OWON-LILLIPUT/scopefun-hardware/README.md

**ScopeFun hardware**

This repository contains Scopefun hardware schematics and pcb layout files.

Licensed under CERN OHL v.1.2

You will need [Kicad](http://kicad-pcb.org/) to open hardware design files
