OWON-LILLIPUT/scopefun-hardware/KiCadSource/file584BA872.sch

## KiCad design KiCadSource/file584BA872.sch (2019-11-21)

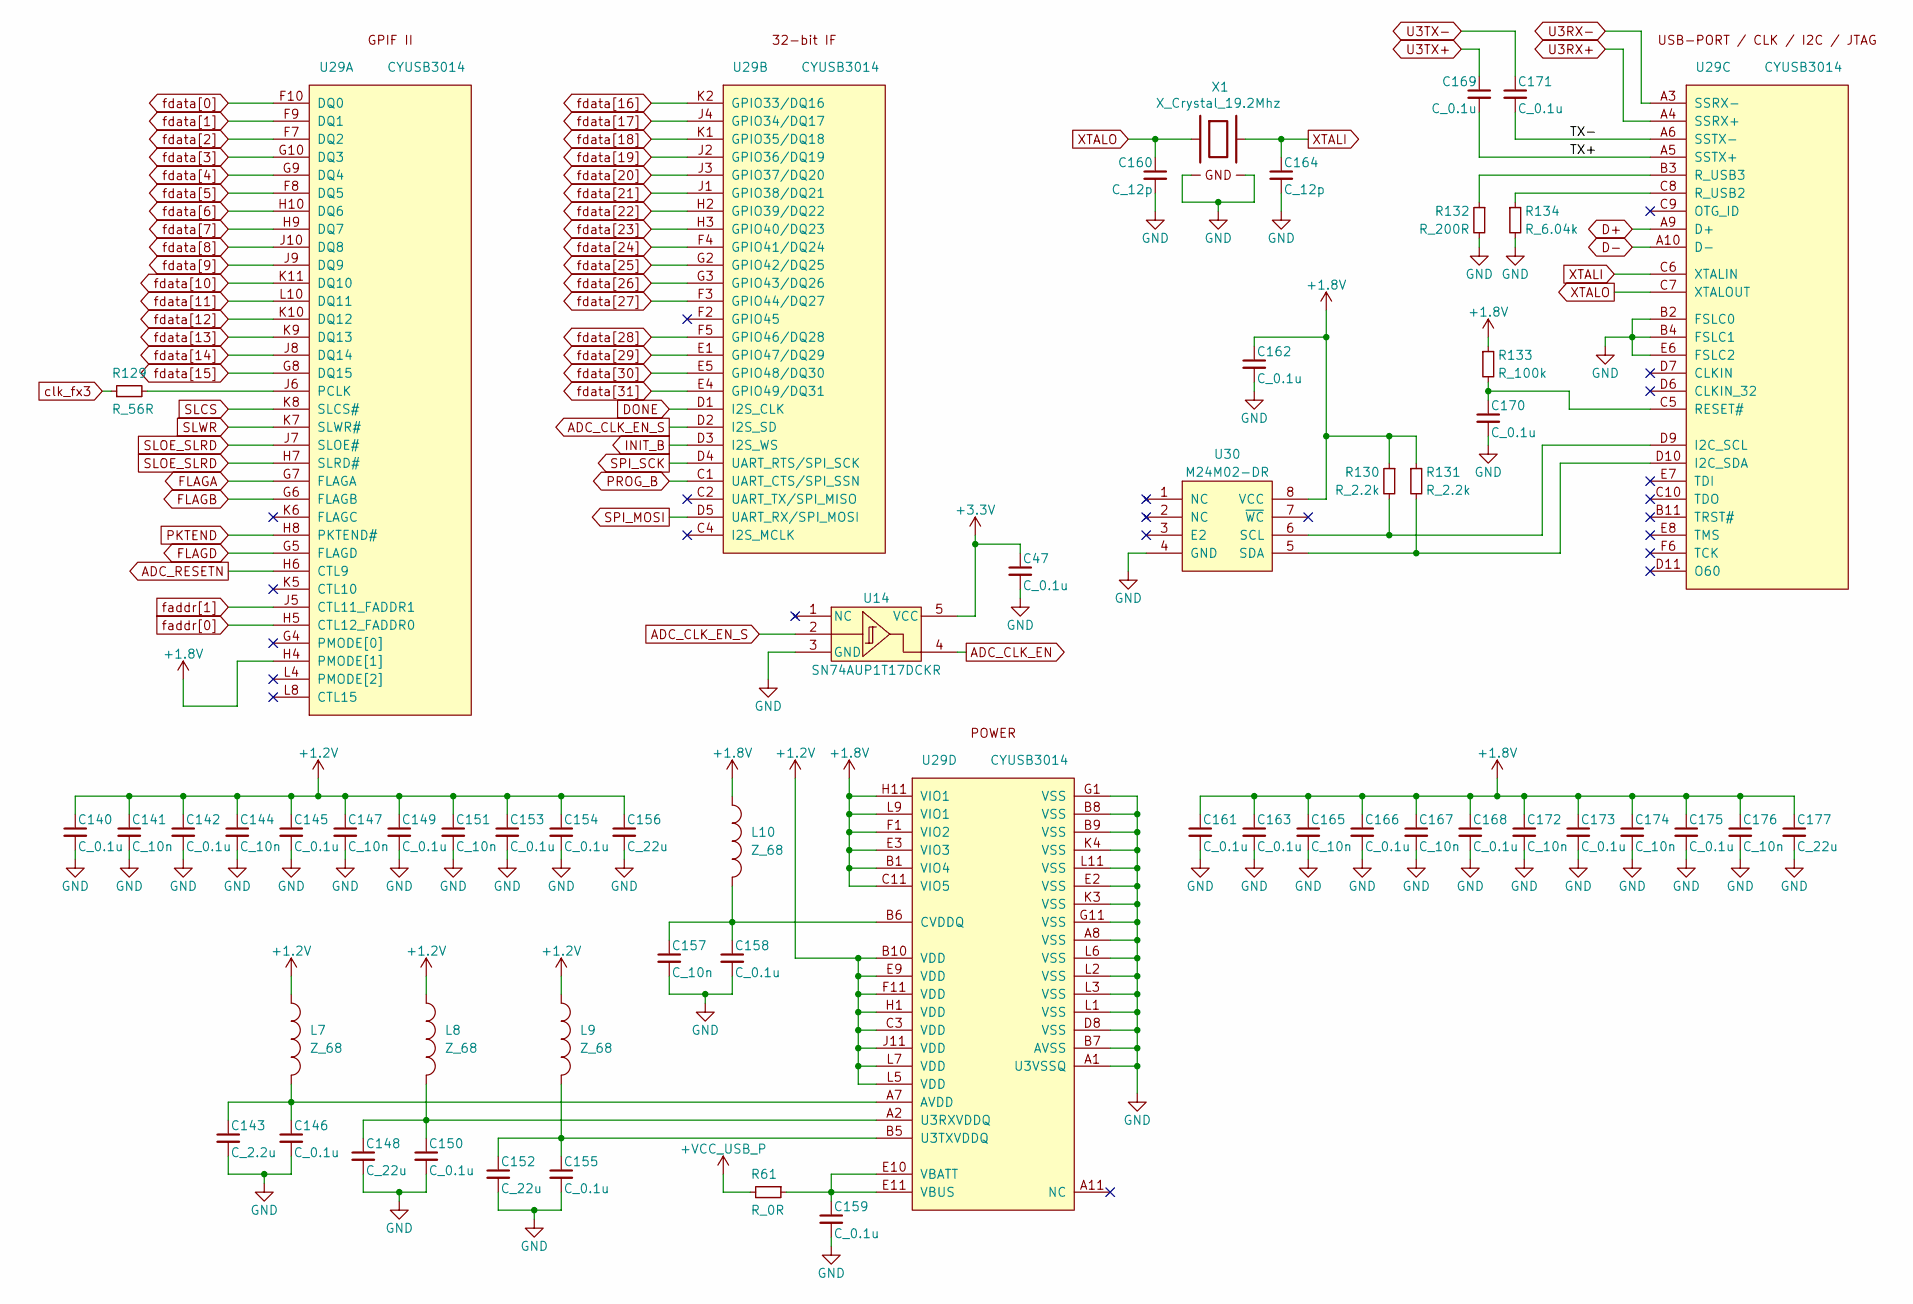
[picture p18: schematic file584BA872.sch]

Parts:
C47, C140, C142, C145, C146, C149, C150, C153, C154, C155, C158, C159, C161, C162, C163, C166, C168, C170, C173, C175: C_0.1u; C_0603; MFG Part# C0603C104K4RACTU
C141, C144, C147, C151, C157, C165, C167, C172, C174, C176: C_10n; C_0603; MFG Part# GRM1885C1H103JA01D
C143: C_2.2u; C_0603; MFG Part# CC0603MRX5R5BB225
C148, C152, C156, C177: C_22u; C_0805; MFG Part# LMK212BBJ226MG-T
C160, C164: C_12p; C_0603; MFG Part# CGA3E2C0G1H120J080AA
C169, C171: C_0.1u; C_0402; MFG Part# 885012205018
L7, L8, L9, L10: Z_68; L_0805; MFG Part# 782853680
R61: R_0R; R_0805; MFG Part# ERJ-6GEY0R00V
R129: R_56R; R_0603; MFG Part# ERJ-3EKF56R0V
R130, R131: R_2.2k; R_0603; MFG Part# ERJ-3EKF2201V
R132: R_200R; R_0603; MFG Part# ERJ-3EKF2000V
R133: R_100k; R_0603; MFG Part# ERJ-3EKF1003V
R134: R_6.04k; R_0603; MFG Part# ERJ-3EKF6041V
U14: SN74AUP1T17DCKR; SC70-5; MFG Part# SN74AUP1T17DCKR
U29: CYUSB3014; BGA121_0.8mm; MFG Part# CYUSB3014-BZXC
U30: M24M02-DR; SOIC8; MFG Part# M24M02-DRMN6TP
X1: X_Crystal_19.2Mhz; XTAL-4; MFG Part# FL1920031

Connections:
+1.2V: C140.1, C141.1, C142.1, C144.1, C145.1, C147.1, C149.1, C151.1, C153.1, C154.1, C156.1, L7.1, L8.1, L9.1, U29.B10 (VDD), U29.C3 (VDD), U29.E9 (VDD), U29.F11 (VDD), U29.H1 (VDD), U29.J11 (VDD), U29.L5 (VDD), U29.L7 (VDD)
+1.8V: C161.1, C162.1, C163.1, C165.1, C166.1, C167.1, C168.1, C172.1, C173.1, C174.1, C175.1, C176.1, C177.1, L10.1, R130.1, R131.1, R133.1, U29.B1 (VIO4), U29.C11 (VIO5), U29.E3 (VIO3), U29.F1 (VIO2), U29.H4 (PMODE[1]), U29.H11 (VIO1), U29.L9 (VIO1), U30.8 (VCC)
+3.3V: C47.1, U14.5 (VCC)
+VCC_USB_P: R61.2
ADC_CLK_EN: U14.4
ADC_CLK_EN_S: U14.2, U29.D2 (I2S_SD)
ADC_RESETN: U29.H6 (CTL9)
D+: U29.A9 (D+)
D-: U29.A10 (D-)
DONE: U29.D1 (I2S_CLK)
FLAGA: U29.G7 (FLAGA)
FLAGB: U29.G6 (FLAGB)
FLAGD: U29.G5 (FLAGD)
GND: C47.2, C140.2, C141.2, C142.2, C143.2, C144.2, C145.2, C146.2, C147.2, C148.2, C149.2, C150.2, C151.2, C152.2, C153.2, C154.2, C155.2, C156.2, C157.2, C158.2, C159.2, C160.2, C161.2, C162.2, C163.2, C164.2, C165.2, C166.2, C167.2, C168.2, C170.2, C172.2, C173.2, C174.2, C175.2, C176.2, C177.2, R132.2, R134.2, U14.3 (GND), U29.A1 (U3VSSQ), U29.A8 (VSS), U29.B2 (FSLC0), U29.B4 (FSLC1), U29.B7 (AVSS), U29.B8 (VSS), U29.B9 (VSS), U29.D8 (VSS), U29.E2 (VSS), U29.E6 (FSLC2), U29.G1 (VSS), U29.G11 (VSS), U29.K3 (VSS), U29.K4 (VSS), U29.L1 (VSS), U29.L2 (VSS), U29.L3 (VSS), U29.L6 (VSS), U29.L11 (VSS), U30.4 (GND), X1.2 (GND), X1.4 (GND)
INIT_B: U29.D3 (I2S_WS)
unnamed: C143.1, C146.1, L7.2, U29.A7 (AVDD)
unnamed: C148.1, C150.1, L8.2, U29.A2 (U3RXVDDQ)
unnamed: C152.1, C155.1, L9.2, U29.B5 (U3TXVDDQ)
unnamed: C157.1, C158.1, L10.2, U29.B6 (CVDDQ)
unnamed: C159.1, R61.1, U29.E10 (VBATT), U29.E11 (VBUS)
unnamed: C170.1, R133.2, U29.C5 (RESET#)
unnamed: R129.2, U29.J6 (PCLK)
unnamed: R130.2, U29.D9 (I2C_SCL), U30.6 (SCL)
unnamed: R131.2, U29.D10 (I2C_SDA), U30.5 (SDA)
unnamed: R132.1, U29.B3 (R_USB3)
unnamed: R134.1, U29.C8 (R_USB2)
PKTEND: U29.H8 (PKTEND#)
PROG_B: U29.C1 (UART_CTS/SPI_SSN)
SLCS: U29.K8 (SLCS#)
SLOE_SLRD: U29.H7 (SLRD#), U29.J7 (SLOE#)
SLWR: U29.K7 (SLWR#)
SPI_MOSI: U29.D5 (UART_RX/SPI_MOSI)
SPI_SCK: U29.D4 (UART_RTS/SPI_SCK)
TX+: C169.2, U29.A5 (SSTX+)
TX-: C171.2, U29.A6 (SSTX-)
U3RX+: U29.A4 (SSRX+)
U3RX-: U29.A3 (SSRX-)
U3TX+: C169.1
U3TX-: C171.1
XTALI: C164.1, U29.C6 (XTALIN), X1.3
XTALO: C160.1, U29.C7 (XTALOUT), X1.1
clk_fx3: R129.1
faddr[0]: U29.H5 (CTL12_FADDR0)
faddr[1]: U29.J5 (CTL11_FADDR1)
fdata[0]: U29.F10 (DQ0)
fdata[1]: U29.F9 (DQ1)
fdata[2]: U29.F7 (DQ2)
fdata[3]: U29.G10 (DQ3)
fdata[4]: U29.G9 (DQ4)
fdata[5]: U29.F8 (DQ5)
fdata[6]: U29.H10 (DQ6)
fdata[7]: U29.H9 (DQ7)
fdata[8]: U29.J10 (DQ8)
fdata[9]: U29.J9 (DQ9)
fdata[10]: U29.K11 (DQ10)
fdata[11]: U29.L10 (DQ11)
fdata[12]: U29.K10 (DQ12)
fdata[13]: U29.K9 (DQ13)
fdata[14]: U29.J8 (DQ14)
fdata[15]: U29.G8 (DQ15)
fdata[16]: U29.K2 (GPIO33/DQ16)
fdata[17]: U29.J4 (GPIO34/DQ17)
fdata[18]: U29.K1 (GPIO35/DQ18)
fdata[19]: U29.J2 (GPIO36/DQ19)
fdata[20]: U29.J3 (GPIO37/DQ20)
fdata[21]: U29.J1 (GPIO38/DQ21)
fdata[22]: U29.H2 (GPIO39/DQ22)
fdata[23]: U29.H3 (GPIO40/DQ23)
fdata[24]: U29.F4 (GPIO41/DQ24)
fdata[25]: U29.G2 (GPIO42/DQ25)
fdata[26]: U29.G3 (GPIO43/DQ26)
fdata[27]: U29.F3 (GPIO44/DQ27)
fdata[28]: U29.F5 (GPIO46/DQ28)
fdata[29]: U29.E1 (GPIO47/DQ29)
fdata[30]: U29.E5 (GPIO48/DQ30)
fdata[31]: U29.E4 (GPIO49/DQ31)
