OWON-LILLIPUT/scopefun-hardware/KiCadSource/file56954A3C.sch

## KiCad design KiCadSource/file56954A3C.sch (2019-11-21)

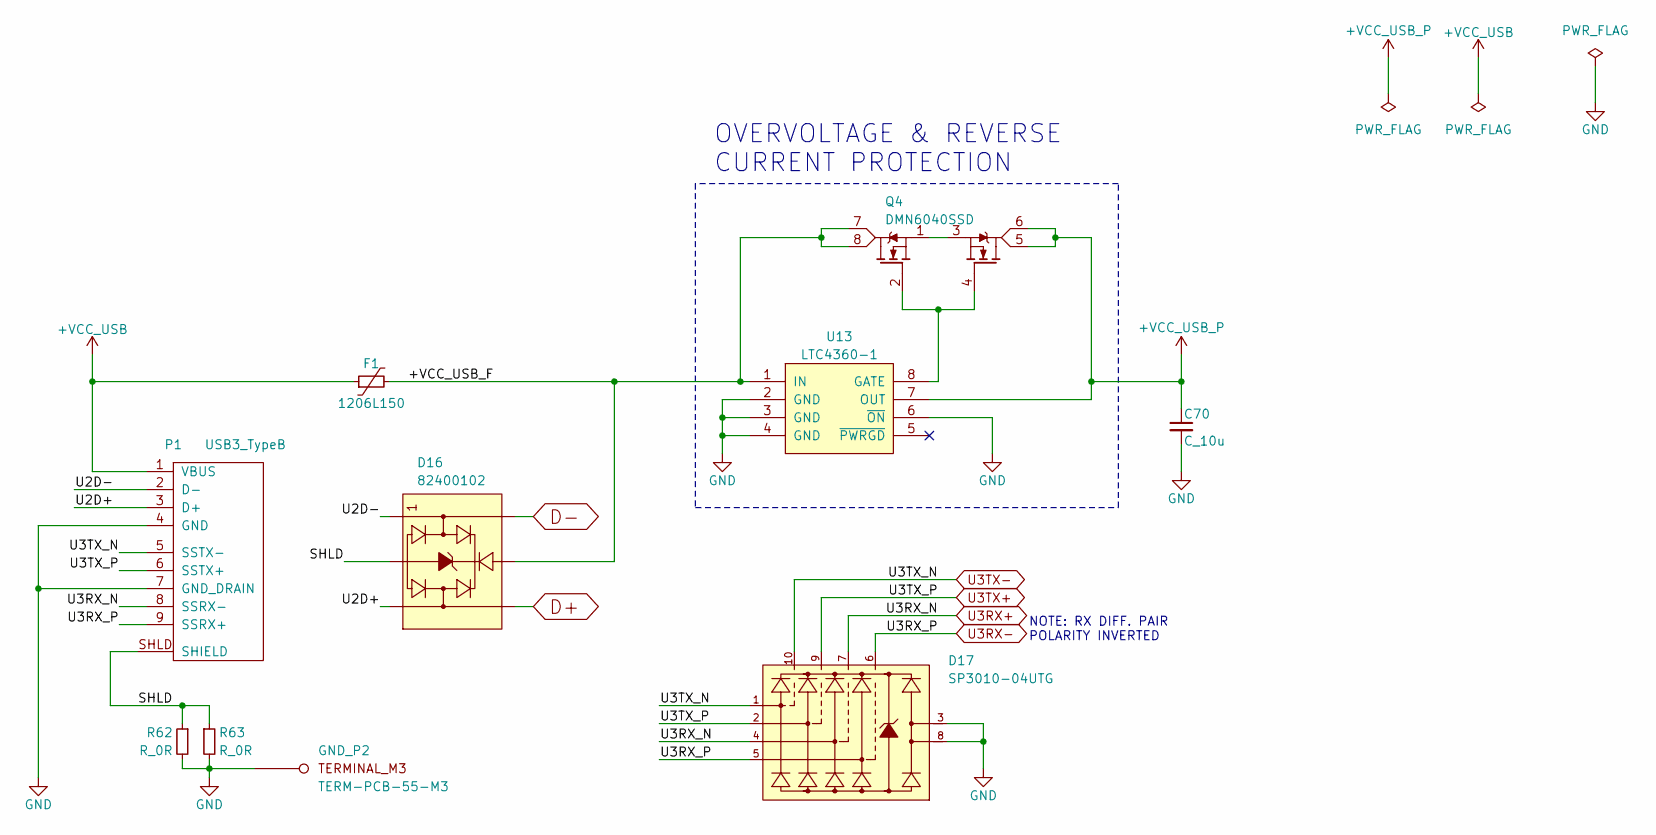
[picture p24: schematic file56954A3C.sch]

Parts:
C70: C_10u; C_0603; MFG Part# GRM188R60J106KE47D
D16: 82400102; SOT23-6; MFG Part# 82400102
D17: SP3010-04UTG; uDFN-10; MFG Part# SP3010-04UTG
F1: 1206L150; R_1206; MFG Part# 1206L150THWR
GND_P2: TERM-PCB-55-M3; MFG Part# PCB-55(M3)
P1: USB3_TypeB; MFG Part# 692221030100
Q4: DMN6040SSD; SOIC8; MFG Part# DMN6040SSD-13
R62, R63: R_0R; R_0805; MFG Part# ERJ-6GEY0R00V
U13: LTC4360-1; SC70; MFG Part# LTC4360CSC8-1

Connections:
+VCC_USB: F1.1, P1.1 (VBUS)
+VCC_USB_F: D16.5 (VDD), F1.2, Q4.7 (D1), Q4.8 (D1), U13.1 (IN)
+VCC_USB_P: C70.1, Q4.5 (D2), Q4.6 (D2), U13.7 (OUT)
D+: D16.4 (IO2)
D-: D16.6 (IO1)
GND: C70.2, D17.3 (IO2), D17.8 (IO1), GND_P2.1, P1.4 (GND), P1.7 (GND_DRAIN), R62.2, R63.2, U13.2 (GND), U13.3 (GND), U13.4 (GND), U13.6 (~ON)
unnamed: Q4.1 (S1), Q4.3 (S2)
unnamed: Q4.2 (G1), Q4.4 (G2), U13.8 (GATE)
SHLD: D16.2 (GND), P1.SHLD (SHIELD), R62.1, R63.1
U2D+: D16.3 (IO2), P1.3 (D+)
U2D-: D16.1 (IO1), P1.2 (D-)
U3RX+: D17.4 (IO2), D17.7 (IO1), P1.8 (SSRX-)
U3RX-: D17.5 (VDD), D17.6 (IO1), P1.9 (SSRX+)
U3TX+: D17.2 (GND), D17.9 (IO1), P1.6 (SSTX+)
U3TX-: D17.1 (IO1), D17.10 (IO1), P1.5 (SSTX-)

Notes on the sheet:
OVERVOLTAGE & REVERSE CURRENT PROTECTION
NOTE: RX DIFF. PAIR POLARITY INVERTED
