OWON-LILLIPUT/scopefun-hardware/KiCadSource/file58568C5C.sch

## KiCad design KiCadSource/file58568C5C.sch (2019-11-21)

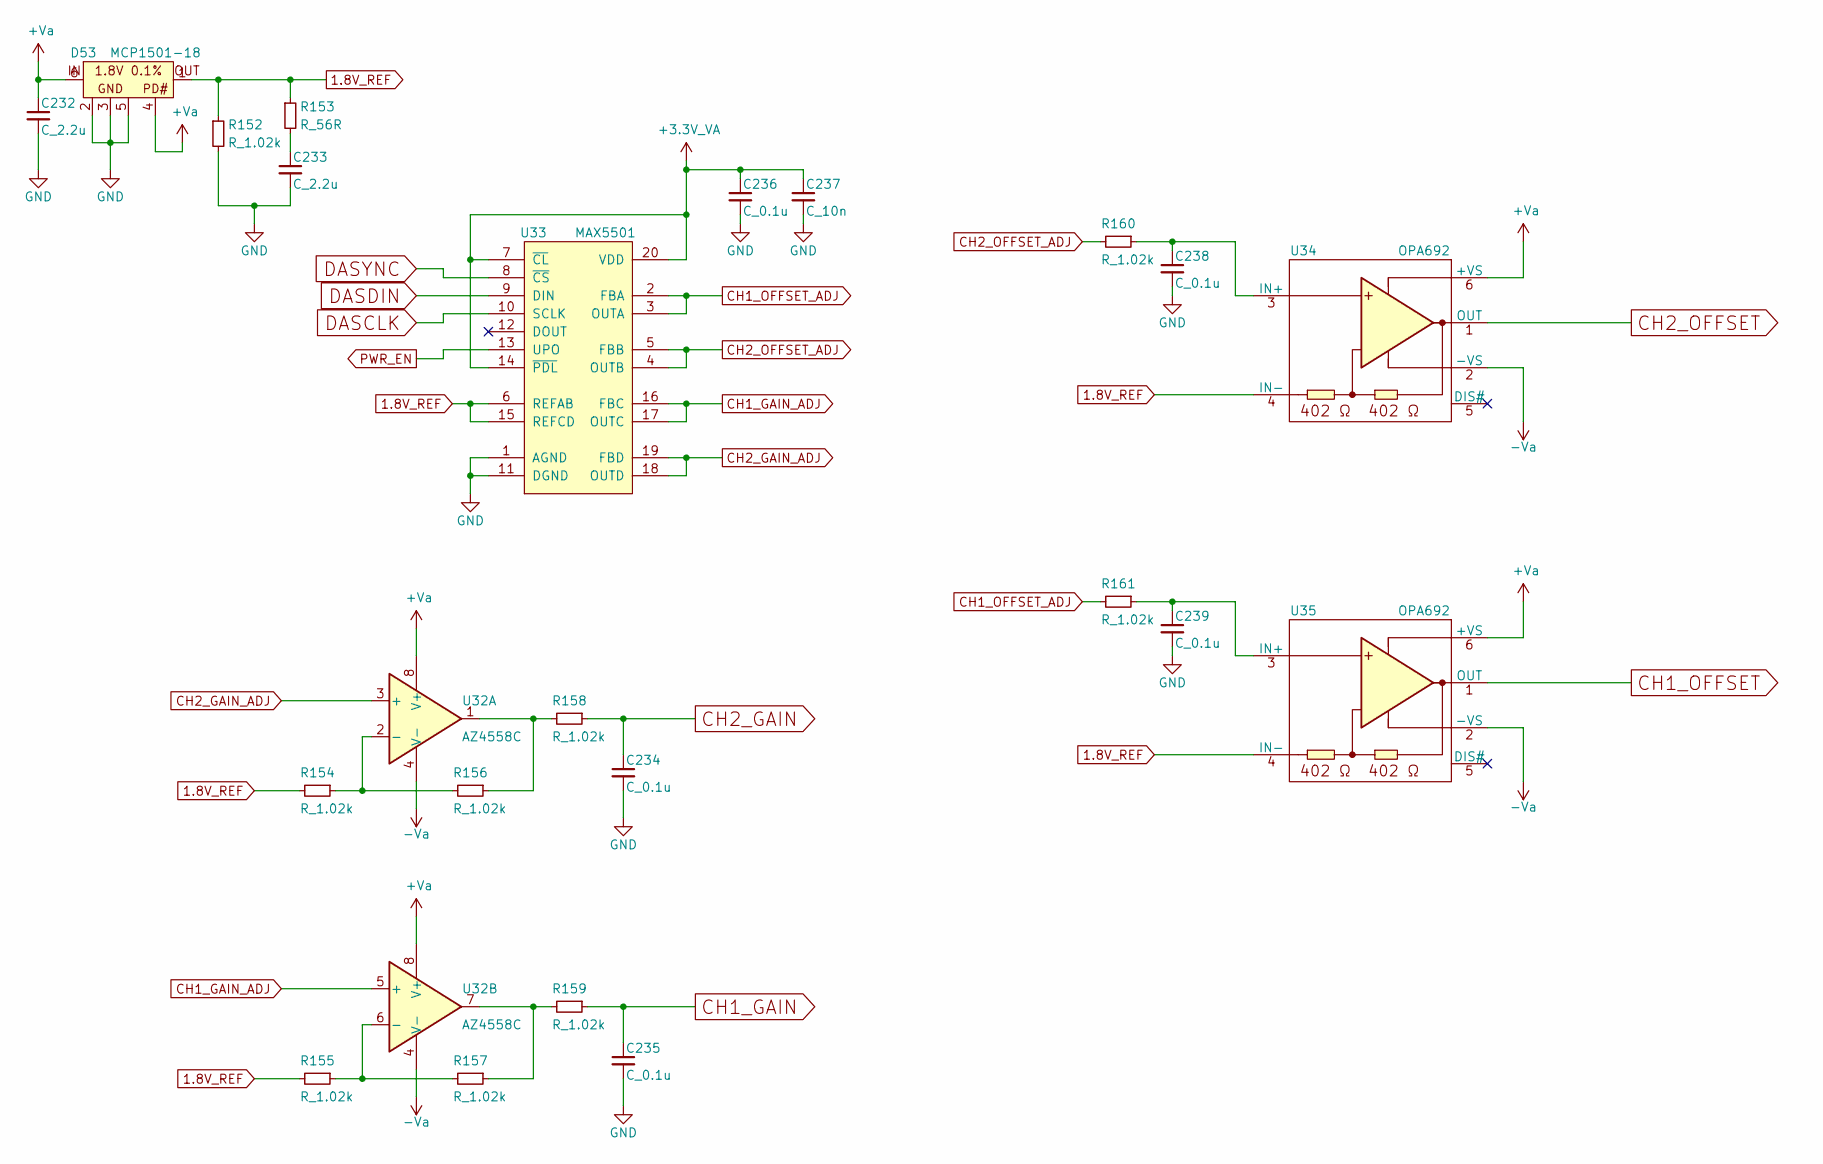
[picture p25: schematic file58568C5C.sch]

Parts:
C232, C233: C_2.2u; C_0603; MFG Part# CC0603MRX5R5BB225
C234, C235, C236, C238, C239: C_0.1u; C_0603; MFG Part# C0603C104K4RACTU
C237: C_10n; C_0402; MFG Part# 885012205012
D53: MCP1501-18; SOT23-6; MFG Part# MCP1501T-18E/CHY
R152, R154, R155, R156, R157, R158, R159, R160, R161: R_1.02k; R_0603; MFG Part# ERJ-3EKF1021V
R153: R_56R; R_0603; MFG Part# ERJ-3EKF56R0V
U32: AZ4558C; SOIC8; MFG Part# AZ4558CMTR-E1
U33: MAX5501; SSOP20; MFG Part# MAX5501BGAP+
U34, U35: OPA692; SOT23-6; MFG Part# OPA692IDBVT

Connections:
1.8V_REF: D53.1 (OUT), R152.1, R153.1, R154.2, R155.2, U33.6 (REFAB), U33.15 (REFCD), U34.4 (IN-), U35.4 (IN-)
+3.3V_VA: C236.1, C237.1, U33.7 (~CL), U33.14 (~PDL), U33.20 (VDD)
+Va: C232.1, D53.4 (SHDN#), D53.6 (VDD), U32.8 (V+), U34.6 (+VS), U35.6 (+VS)
-Va: U32.4 (V-), U34.2 (-VS), U35.2 (-VS)
CH1_GAIN: C235.1, R159.1
CH1_GAIN_ADJ: U32.5 (+), U33.16 (FBC), U33.17 (OUTC)
CH1_OFFSET: U35.1 (OUT)
CH1_OFFSET_ADJ: R161.2, U33.2 (FBA), U33.3 (OUTA)
CH2_GAIN: C234.1, R158.1
CH2_GAIN_ADJ: U32.3 (+), U33.18 (OUTD), U33.19 (FBD)
CH2_OFFSET: U34.1 (OUT)
CH2_OFFSET_ADJ: R160.2, U33.4 (OUTB), U33.5 (FBB)
DASCLK: U33.10 (SCLK)
DASDIN: U33.9 (DIN)
DASYNC: U33.8 (~CS)
GND: C232.2, C233.2, C234.2, C235.2, C236.2, C237.2, C238.2, C239.2, D53.2 (GND), D53.3 (GND), D53.5 (GND), R152.2, U33.1 (AGND), U33.11 (DGND)
unnamed: C233.1, R153.2
unnamed: C238.1, R160.1, U34.3 (IN+)
unnamed: C239.1, R161.1, U35.3 (IN+)
unnamed: R154.1, R156.2, U32.2 (-)
unnamed: R155.1, R157.2, U32.6 (-)
unnamed: R156.1, R158.2, U32.1
unnamed: R157.1, R159.2, U32.7
PWR_EN: U33.13 (UPO)
