OWON-LILLIPUT/scopefun-hardware/KiCadSource/file58589F31.sch

## KiCad design KiCadSource/file58589F31.sch (2019-11-21)

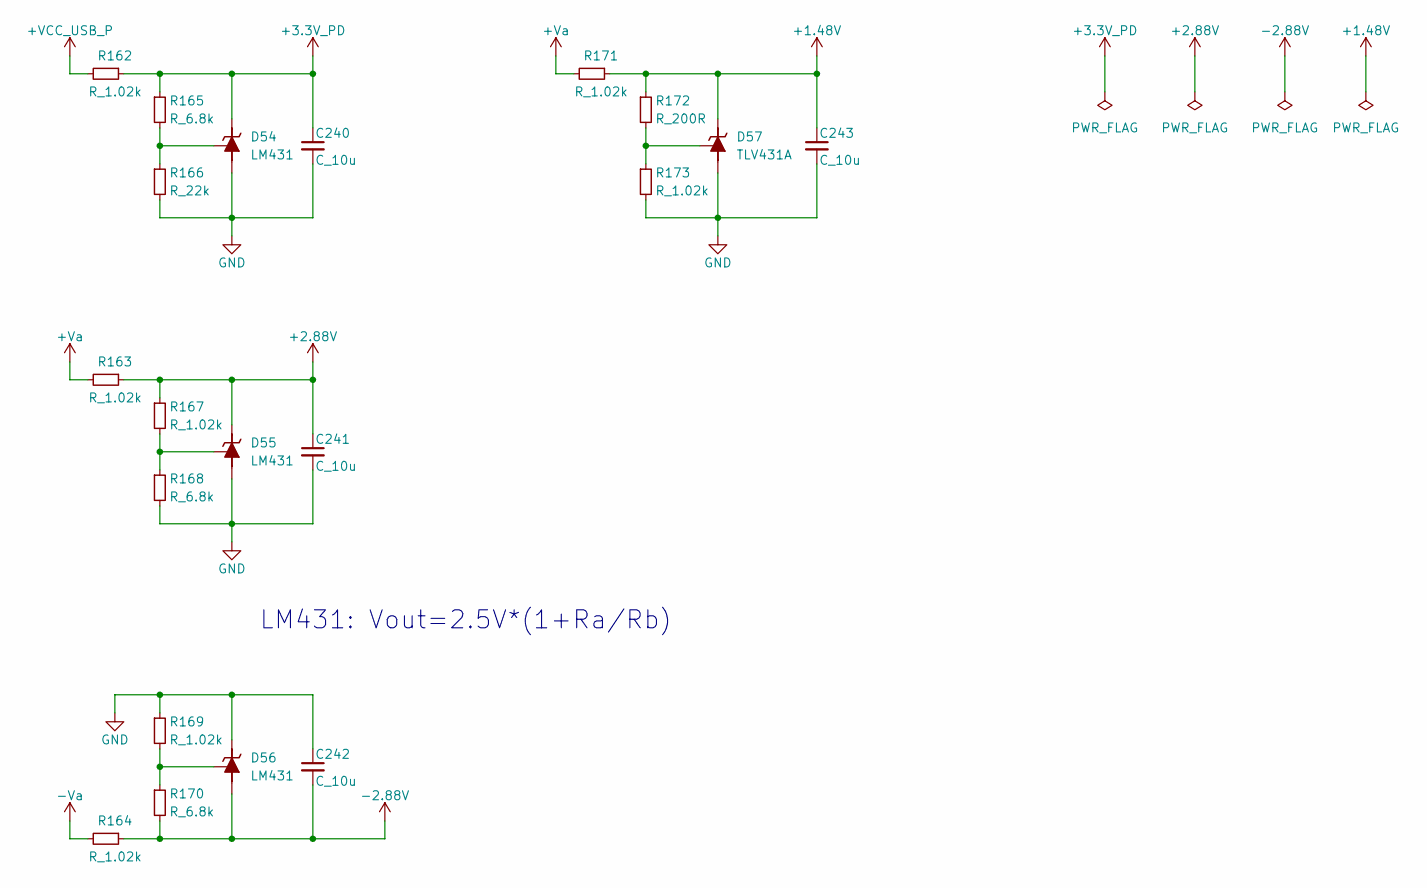
[picture p26: schematic file58589F31.sch]

Parts:
C240, C241, C242, C243: C_10u; C_0603; MFG Part# GRM188R60J106KE47D
D54, D55, D56: LM431; SOT23; MFG Part# LM431SBCM32X
D57: TLV431A; SOT23; MFG Part# TLV431ASN1T1G
R162, R163, R164, R167, R169, R171, R173: R_1.02k; R_0603; MFG Part# ERJ-3EKF1021V
R165, R168, R170: R_6.8k; R_0603; MFG Part# ERJ-3EKF6801V
R166: R_22k; R_0603; MFG Part# ERJ-3EKF2202V
R172: R_200R; R_0603; MFG Part# ERJ-3EKF2000V

Connections:
+1.48V: C243.1, D57.2 (C), R171.1, R172.1
+2.88V: C241.1, D55.1 (C), R163.1, R167.1
+3.3V_PD: C240.1, D54.1 (C), R162.1, R165.1
+VCC_USB_P: R162.2
+Va: R163.2, R171.2
-2.88V: C242.2, D56.3 (A), R164.1, R170.2
-Va: R164.2
GND: C240.2, C241.2, C242.1, C243.2, D54.3 (A), D55.3 (A), D56.1 (C), D57.3 (A), R166.2, R168.2, R169.1, R173.2
unnamed: D54.2 (REF), R165.2, R166.1
unnamed: D55.2 (REF), R167.2, R168.1
unnamed: D56.2 (REF), R169.2, R170.1
unnamed: D57.1 (REF), R172.2, R173.1

Notes on the sheet:
LM431: Vout=2.5V*(1+Ra/Rb)
