OWON-LILLIPUT/scopefun-hardware/KiCadSource/file58597EF4.sch

## KiCad design KiCadSource/file58597EF4.sch (2019-11-21)

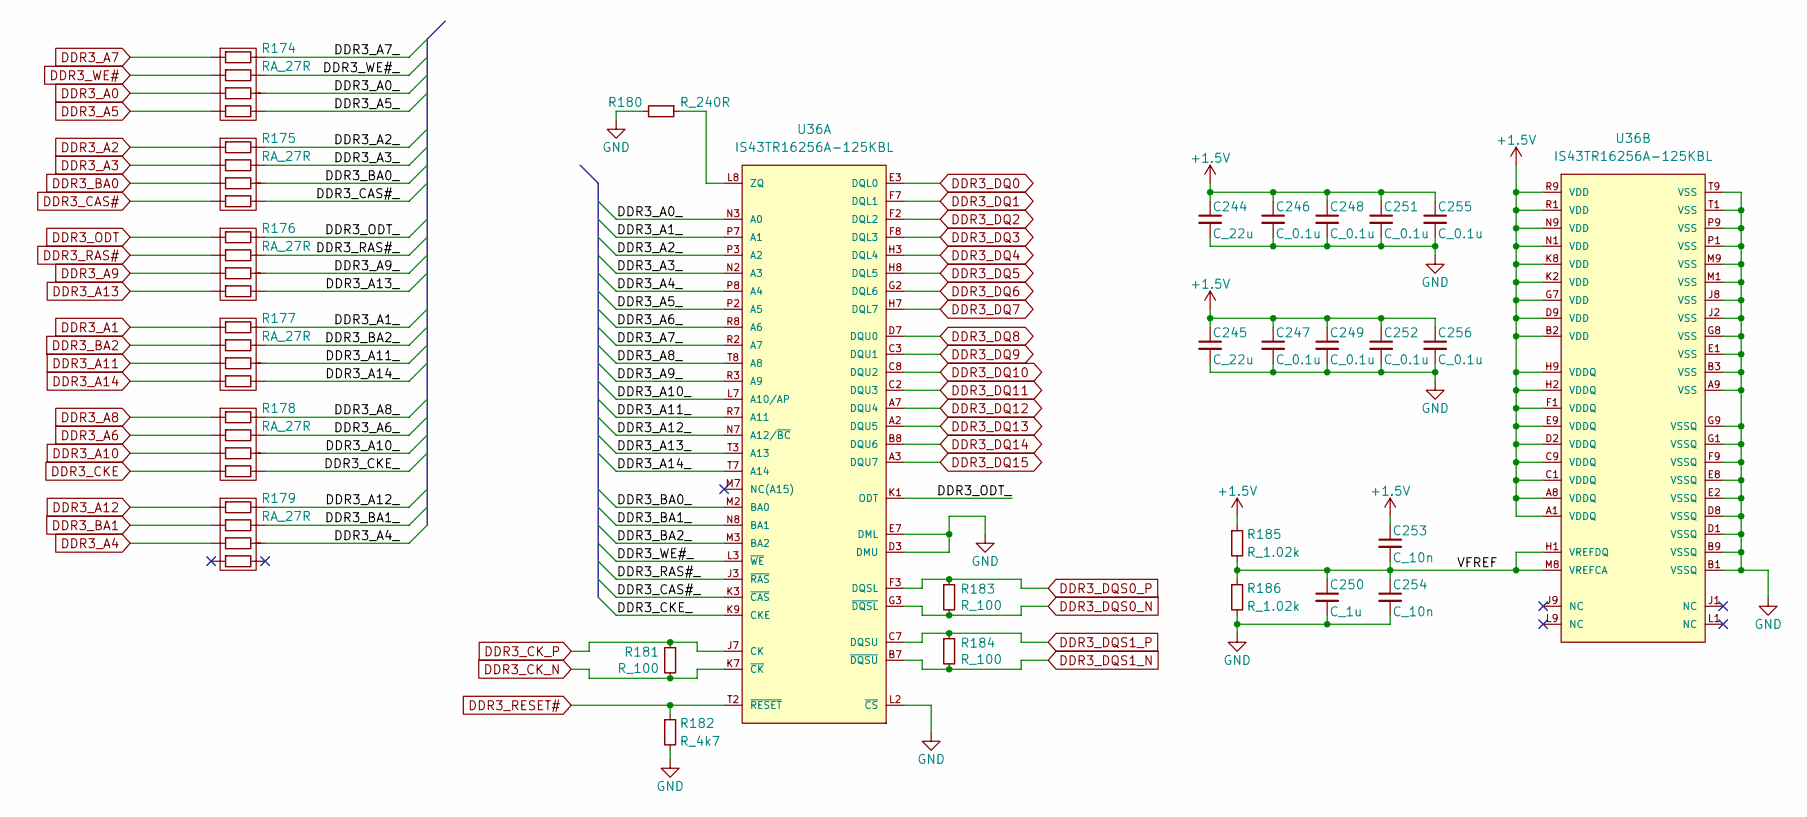
[picture p27: schematic file58597EF4.sch]

Parts:
C244, C245: C_22u; C_0805; MFG Part# LMK212BBJ226MG-T
C246, C247, C248, C249, C251, C252, C255, C256: C_0.1u; C_0603; MFG Part# C0603C104K4RACTU
C250: C_1u; C_0603; MFG Part# C0603C105K9PACTU
C253, C254: C_10n; C_0603; MFG Part# GRM1885C1H103JA01D
R174, R175, R176, R177, R178, R179: RA_27R; R_CRA06E; MFG Part# YC164-JR-0727RL
R180: R_240R; R_0603; MFG Part# ERJ-3EKF2400V
R181, R183, R184: R_100; R_0402; MFG Part# ERJ-2RKF1000X
R182: R_4k7; R_0603; MFG Part# ERJ-3EKF4701V
R185, R186: R_1.02k; R_0603; MFG Part# ERJ-3EKF1021V
U36: IS43TR16256A-125KBL; TW-BGA-96; MFG Part# IS43TR16256A-125KBL

Connections:
+1.5V: C244.1, C245.1, C246.1, C247.1, C248.1, C249.1, C251.1, C252.1, C253.1, C255.1, C256.1, R185.1, U36.A1 (VDDQ), U36.A8 (VDDQ), U36.B2 (VDD), U36.C1 (VDDQ), U36.C9 (VDDQ), U36.D2 (VDDQ), U36.D9 (VDD), U36.E9 (VDDQ), U36.F1 (VDDQ), U36.G7 (VDD), U36.H2 (VDDQ), U36.H9 (VDDQ), U36.K2 (VDD), U36.K8 (VDD), U36.N1 (VDD), U36.N9 (VDD), U36.R1 (VDD), U36.R9 (VDD)
DDR3_A0: R174.6
DDR3_A0_: R174.3, U36.N3 (A0)
DDR3_A1: R177.8
DDR3_A1_: R177.1, U36.P7 (A1)
DDR3_A2: R175.8
DDR3_A2_: R175.1, U36.P3 (A2)
DDR3_A3: R175.7
DDR3_A3_: R175.2, U36.N2 (A3)
DDR3_A4: R179.6
DDR3_A4_: R179.3, U36.P8 (A4)
DDR3_A5: R174.5
DDR3_A5_: R174.4, U36.P2 (A5)
DDR3_A6: R178.7
DDR3_A6_: R178.2, U36.R8 (A6)
DDR3_A7: R174.8
DDR3_A7_: R174.1, U36.R2 (A7)
DDR3_A8: R178.8
DDR3_A8_: R178.1, U36.T8 (A8)
DDR3_A9: R176.6
DDR3_A9_: R176.3, U36.R3 (A9)
DDR3_A10: R178.6
DDR3_A10_: R178.3, U36.L7 (A10/AP)
DDR3_A11: R177.6
DDR3_A11_: R177.3, U36.R7 (A11)
DDR3_A12: R179.8
DDR3_A12_: R179.1, U36.N7 (A12/~BC)
DDR3_A13: R176.5
DDR3_A13_: R176.4, U36.T3 (A13)
DDR3_A14: R177.5
DDR3_A14_: R177.4, U36.T7 (A14)
DDR3_BA0: R175.6
DDR3_BA0_: R175.3, U36.M2 (BA0)
DDR3_BA1: R179.7
DDR3_BA1_: R179.2, U36.N8 (BA1)
DDR3_BA2: R177.7
DDR3_BA2_: R177.2, U36.M3 (BA2)
DDR3_CAS#: R175.5
DDR3_CAS#_: R175.4, U36.K3 (~CAS)
DDR3_CKE: R178.5
DDR3_CKE_: R178.4, U36.K9 (CKE)
DDR3_CK_N: R181.2, U36.K7 (~CK)
DDR3_CK_P: R181.1, U36.J7 (CK)
DDR3_DQ0: U36.E3 (DQL0)
DDR3_DQ1: U36.F7 (DQL1)
DDR3_DQ2: U36.F2 (DQL2)
DDR3_DQ3: U36.F8 (DQL3)
DDR3_DQ4: U36.H3 (DQL4)
DDR3_DQ5: U36.H8 (DQL5)
DDR3_DQ6: U36.G2 (DQL6)
DDR3_DQ7: U36.H7 (DQL7)
DDR3_DQ8: U36.D7 (DQU0)
DDR3_DQ9: U36.C3 (DQU1)
DDR3_DQ10: U36.C8 (DQU2)
DDR3_DQ11: U36.C2 (DQU3)
DDR3_DQ12: U36.A7 (DQU4)
DDR3_DQ13: U36.A2 (DQU5)
DDR3_DQ14: U36.B8 (DQU6)
DDR3_DQ15: U36.A3 (DQU7)
DDR3_DQS0_N: R183.2, U36.G3 (~DQSL)
DDR3_DQS0_P: R183.1, U36.F3 (DQSL)
DDR3_DQS1_N: R184.2, U36.B7 (~DQSU)
DDR3_DQS1_P: R184.1, U36.C7 (DQSU)
DDR3_ODT: R176.8
DDR3_ODT_: R176.1, U36.K1 (ODT)
DDR3_RAS#: R176.7
DDR3_RAS#_: R176.2, U36.J3 (~RAS)
DDR3_RESET#: R182.1, U36.T2 (~RESET)
DDR3_WE#: R174.7
DDR3_WE#_: R174.2, U36.L3 (~WE)
GND: C244.2, C245.2, C246.2, C247.2, C248.2, C249.2, C250.2, C251.2, C252.2, C254.2, C255.2, C256.2, R180.2, R182.2, R186.2, U36.A9 (VSS), U36.B1 (VSSQ), U36.B3 (VSS), U36.B9 (VSSQ), U36.D1 (VSSQ), U36.D3 (DMU), U36.D8 (VSSQ), U36.E1 (VSS), U36.E2 (VSSQ), U36.E7 (DML), U36.E8 (VSSQ), U36.F9 (VSSQ), U36.G1 (VSSQ), U36.G8 (VSS), U36.G9 (VSSQ), U36.J2 (VSS), U36.J8 (VSS), U36.L2 (~CS), U36.M1 (VSS), U36.M9 (VSS), U36.P1 (VSS), U36.P9 (VSS), U36.T1 (VSS), U36.T9 (VSS)
unnamed: R180.1, U36.L8 (ZQ)
VFREF: C250.1, C253.2, C254.1, R185.2, R186.1, U36.H1 (VREFDQ), U36.M8 (VREFCA)
