OWON-LILLIPUT/scopefun-hardware/KiCadSource/file56921512.sch

## KiCad design KiCadSource/file56921512.sch (2019-11-21)

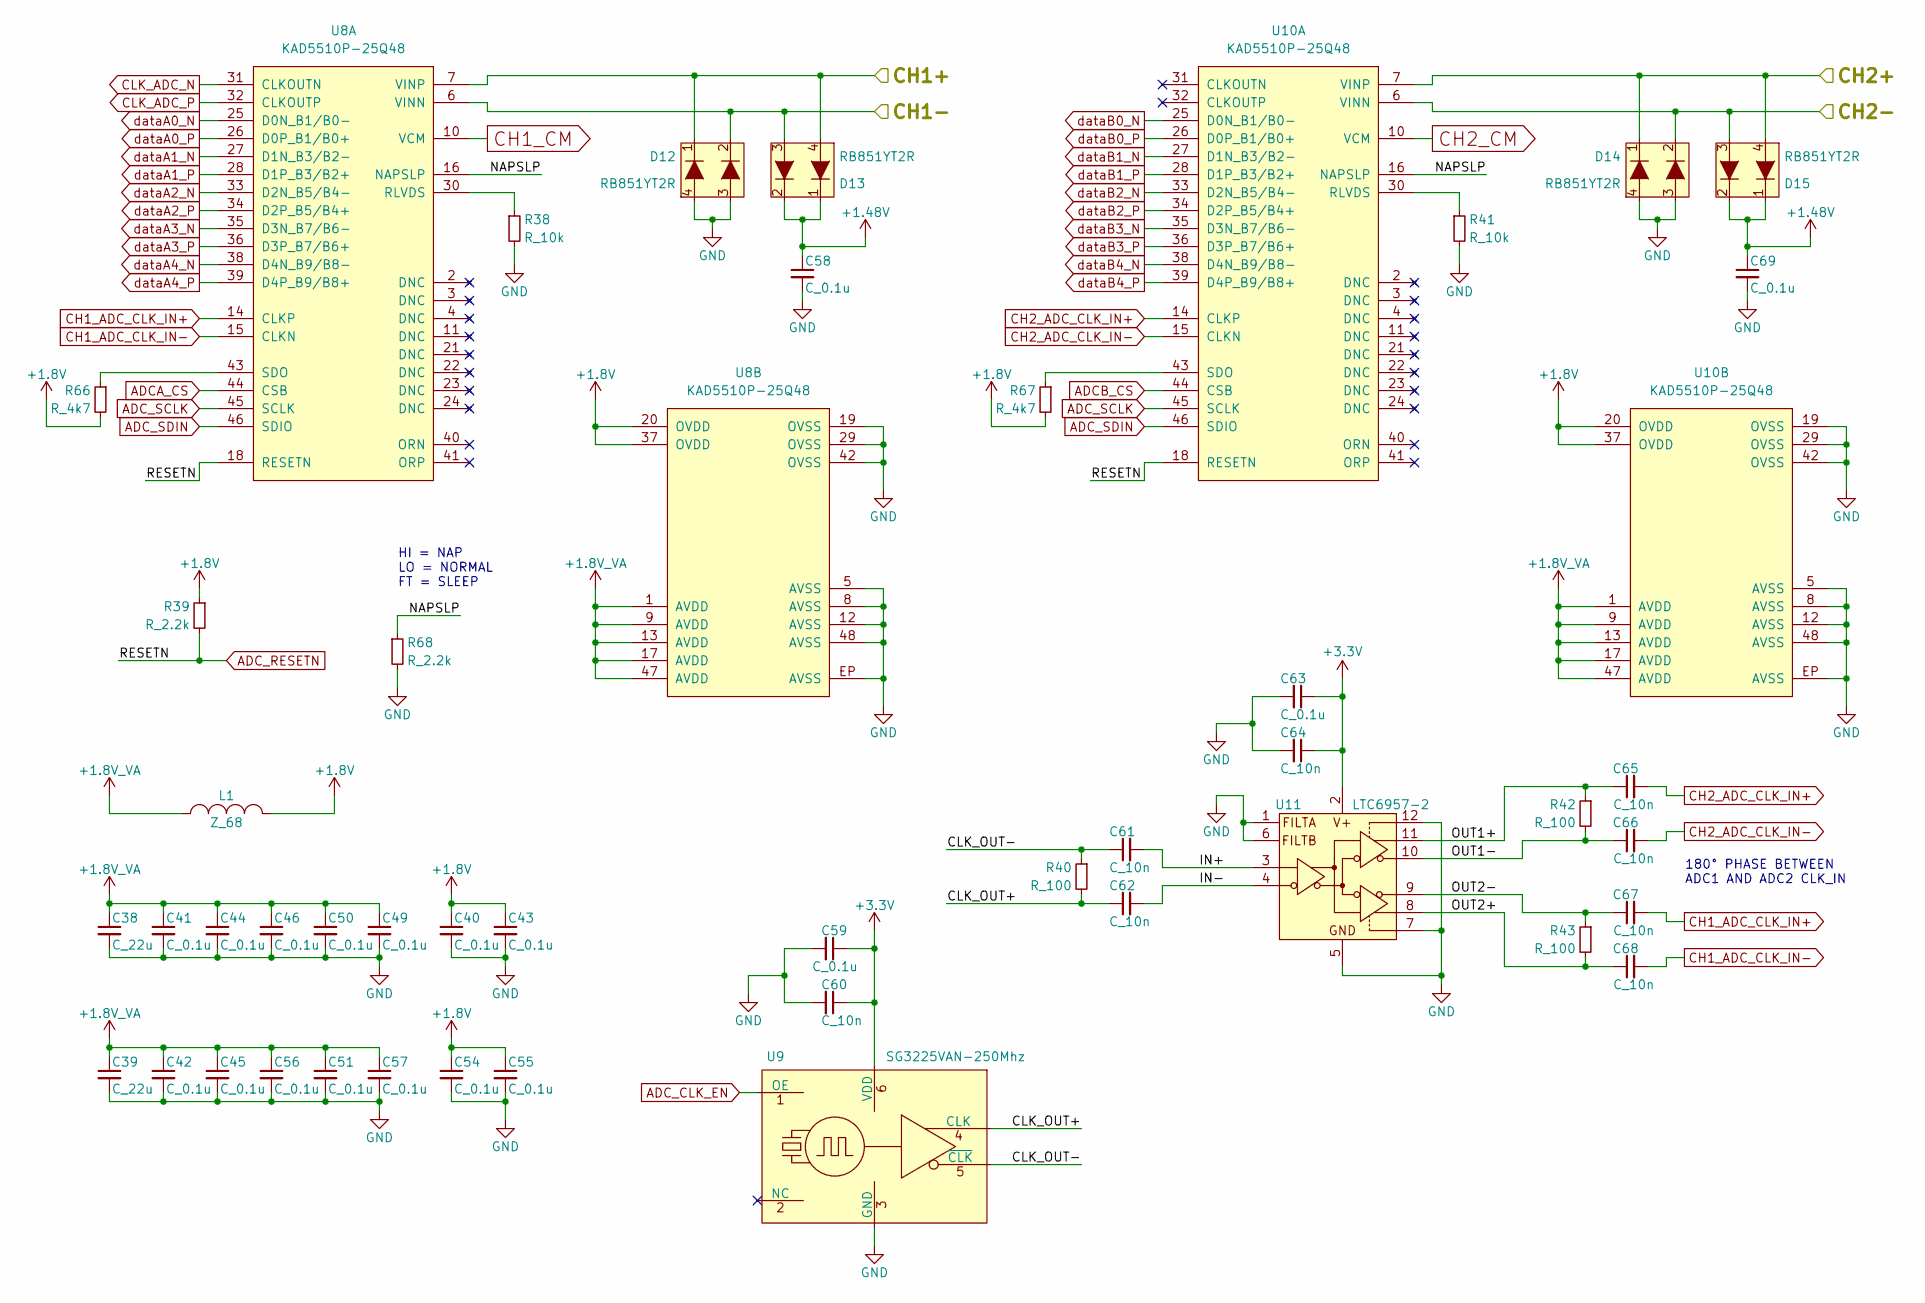
[picture p28: schematic file56921512.sch]

Parts:
C38, C39: C_22u; C_0805; MFG Part# LMK212BBJ226MG-T
C40, C41, C42, C43, C44, C45, C46, C49, C50, C51, C54, C55, C56, C57, C58, C59, C63, C69: C_0.1u; C_0603; MFG Part# C0603C104K4RACTU
C60, C61, C62, C64, C65, C66, C67, C68: C_10n; C_0402; MFG Part# 885012205012
D12, D13, D14, D15: RB851YT2R; SOT-543; MFG Part# RB851YT2R
L1: Z_68; L_0805; MFG Part# 782853680
R38, R41: R_10k; R_0603; MFG Part# ERJ-3EKF1002V
R39, R68: R_2.2k; R_0603; MFG Part# ERJ-3EKF2201V
R40, R42, R43: R_100; R_0402; MFG Part# ERJ-2RKF1000X
R66, R67: R_4k7; R_0603; MFG Part# ERJ-3EKF4701V
U8, U10: KAD5510P-25Q48; CP-56-2; MFG Part# KAD5510P-25Q48
U9: SG3225VAN-250Mhz; 3.2X2.5_SMD_6_EPSON; MFG Part# SG3225VAN 250.000000M-KEGA3
U11: LTC6957-2; 12-MSOP; MFG Part# LTC6957HMS-2#PBF

Connections:
+1.8V: C40.1, C43.1, C54.1, C55.1, L1.1, R39.1, R66.2, R67.2, U8.20 (OVDD), U8.37 (OVDD), U10.20 (OVDD), U10.37 (OVDD)
+1.8V_VA: C38.1, C39.1, C41.1, C42.1, C44.1, C45.1, C46.1, C49.1, C50.1, C51.1, C56.1, C57.1, L1.2, U8.1 (AVDD), U8.9 (AVDD), U8.13 (AVDD), U8.17 (AVDD), U8.47 (AVDD), U10.1 (AVDD), U10.9 (AVDD), U10.13 (AVDD), U10.17 (AVDD), U10.47 (AVDD)
+1.48V: C58.1, C69.1, D13.1, D13.2, D15.1, D15.2
+3.3V: C59.1, C60.1, C63.1, C64.1, U9.6 (VDD), U11.2 (V+)
ADCA_CS: U8.44 (CSB)
ADCB_CS: U10.44 (CSB)
ADC_CLK_EN: U9.1 (OE)
ADC_RESETN: R39.2, U8.18 (RESETN), U10.18 (RESETN)
ADC_SCLK: U8.45 (SCLK), U10.45 (SCLK)
ADC_SDIN: U8.46 (SDIO), U10.46 (SDIO)
CH1+: D12.1, D13.4, U8.7 (VINP)
CH1-: D12.2, D13.3, U8.6 (VINN)
CH1_ADC_CLK_IN+: C67.2, U8.14 (CLKP)
CH1_ADC_CLK_IN-: C68.2, U8.15 (CLKN)
CH1_CM: U8.10 (VCM)
CH2+: D14.1, D15.4, U10.7 (VINP)
CH2-: D14.2, D15.3, U10.6 (VINN)
CH2_ADC_CLK_IN+: C65.2, U10.14 (CLKP)
CH2_ADC_CLK_IN-: C66.2, U10.15 (CLKN)
CH2_CM: U10.10 (VCM)
CLK_ADC_N: U8.31 (CLKOUTN)
CLK_ADC_P: U8.32 (CLKOUTP)
CLK_OUT+: C62.1, R40.2, U9.4 (CLK)
CLK_OUT-: C61.1, R40.1, U9.5 (~CLK)
GND: C38.2, C39.2, C40.2, C41.2, C42.2, C43.2, C44.2, C45.2, C46.2, C49.2, C50.2, C51.2, C54.2, C55.2, C56.2, C57.2, C58.2, C59.2, C60.2, C63.2, C64.2, C69.2, D12.3, D12.4, D14.3, D14.4, R38.2, R41.2, R68.2, U8.5 (AVSS), U8.8 (AVSS), U8.12 (AVSS), U8.19 (OVSS), U8.29 (OVSS), U8.42 (OVSS), U8.48 (AVSS), U8.EP (AVSS), U9.3 (GND), U10.5 (AVSS), U10.8 (AVSS), U10.12 (AVSS), U10.19 (OVSS), U10.29 (OVSS), U10.42 (OVSS), U10.48 (AVSS), U10.EP (AVSS), U11.1 (FILTA), U11.5 (GND), U11.6 (FILTB), U11.7 (SD2), U11.12 (SD1)
IN+: C61.2, U11.3 (IN+)
IN-: C62.2, U11.4 (IN-)
NAPSLP: R68.1, U8.16 (NAPSLP), U10.16 (NAPSLP)
unnamed: R38.1, U8.30 (RLVDS)
unnamed: R41.1, U10.30 (RLVDS)
unnamed: R66.1, U8.43 (SDO)
unnamed: R67.1, U10.43 (SDO)
OUT1+: C65.1, R42.1, U11.11 (OUT1+)
OUT1-: C66.1, R42.2, U11.10 (OUT1-)
OUT2+: C68.1, R43.2, U11.8 (OUT2+)
OUT2-: C67.1, R43.1, U11.9 (OUT2-)
dataA0_N: U8.25 (D0N_B1/B0-)
dataA0_P: U8.26 (D0P_B1/B0+)
dataA1_N: U8.27 (D1N_B3/B2-)
dataA1_P: U8.28 (D1P_B3/B2+)
dataA2_N: U8.33 (D2N_B5/B4-)
dataA2_P: U8.34 (D2P_B5/B4+)
dataA3_N: U8.35 (D3N_B7/B6-)
dataA3_P: U8.36 (D3P_B7/B6+)
dataA4_N: U8.38 (D4N_B9/B8-)
dataA4_P: U8.39 (D4P_B9/B8+)
dataB0_N: U10.25 (D0N_B1/B0-)
dataB0_P: U10.26 (D0P_B1/B0+)
dataB1_N: U10.27 (D1N_B3/B2-)
dataB1_P: U10.28 (D1P_B3/B2+)
dataB2_N: U10.33 (D2N_B5/B4-)
dataB2_P: U10.34 (D2P_B5/B4+)
dataB3_N: U10.35 (D3N_B7/B6-)
dataB3_P: U10.36 (D3P_B7/B6+)
dataB4_N: U10.38 (D4N_B9/B8-)
dataB4_P: U10.39 (D4P_B9/B8+)

Notes on the sheet:
180° PHASE BETWEEN ADC1 AND ADC2 CLK_IN
HI = NAP LO = NORMAL FT = SLEEP
