OWON-LILLIPUT/scopefun-hardware/KiCadSource/file56948067.sch

## KiCad design KiCadSource/file56948067.sch (2019-11-21)

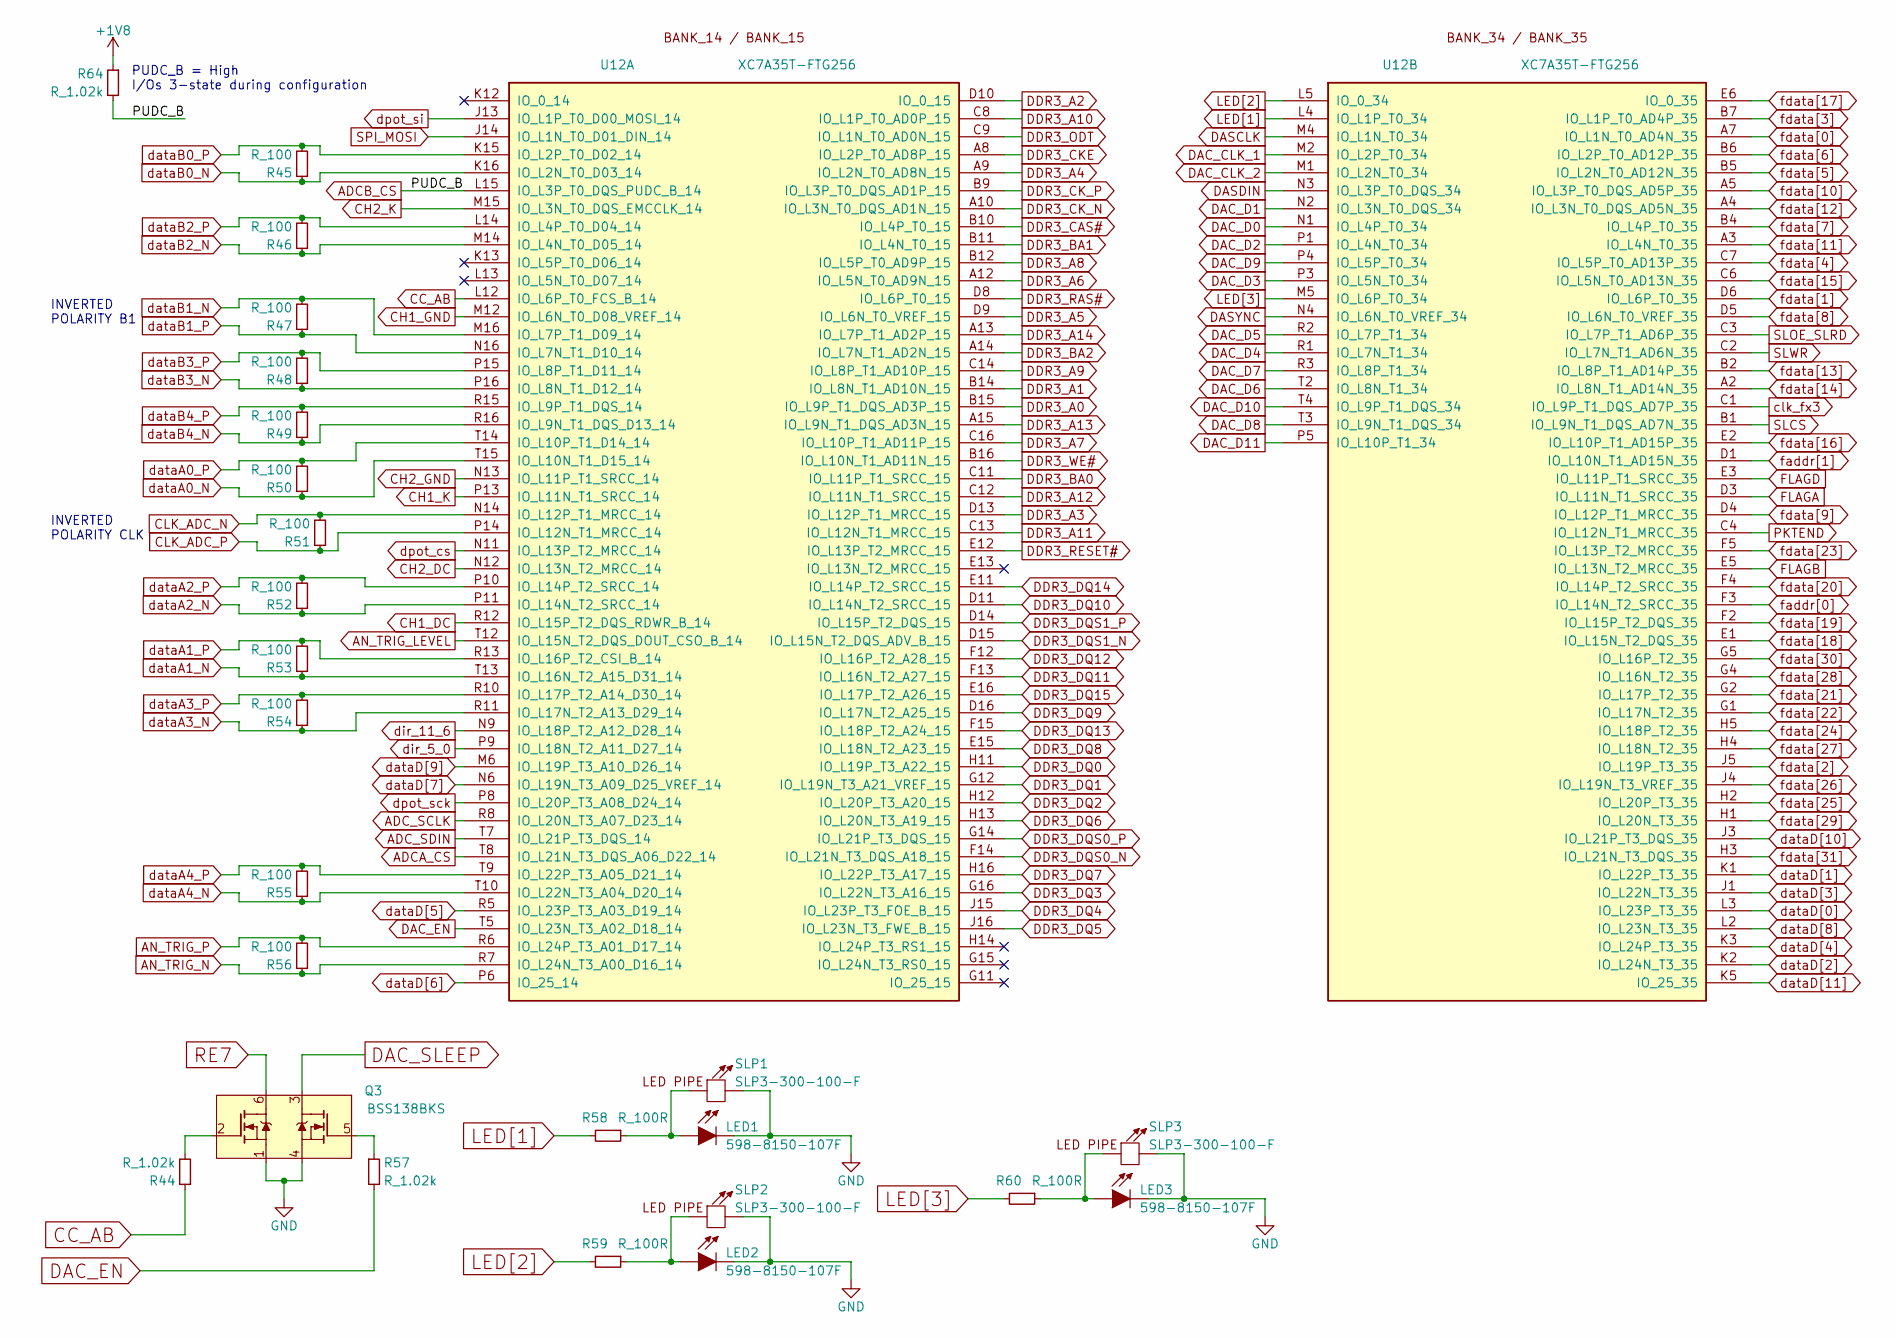
[picture p29: schematic file56948067.sch]

Parts:
LED1, LED2, LED3: 598-8150-107F; LED_0805; MFG Part# 598-8150-107F
Q3: BSS138BKS; SOT363; MFG Part# BSS138PS,115
R44, R57, R64: R_1.02k; R_0603; MFG Part# ERJ-3EKF1021V
R45, R46, R47, R48, R49, R50, R51, R52, R53, R54, R55, R56: R_100; R_0402; MFG Part# ERJ-2RKF1000X
R58, R59, R60: R_100R; R_0603; MFG Part# ERJ-3EKF1000V
SLP1, SLP2, SLP3: SLP3-300-100-F; MFG Part# SLP3-300-100-F
U12: XC7A35T-FTG256; BGA256_FTG256; MFG Part# XC7A35T-2FTG256I

Connections:
+1V8: R64.1
ADCA_CS: U12.T8 (IO_L21N_T3_DQS_A06_D22_14)
ADCB_CS: R64.2, U12.L15 (IO_L3P_T0_DQS_PUDC_B_14)
ADC_SCLK: U12.R8 (IO_L20N_T3_A07_D23_14)
ADC_SDIN: U12.T7 (IO_L21P_T3_DQS_14)
AN_TRIG_LEVEL: U12.T12 (IO_L15N_T2_DQS_DOUT_CSO_B_14)
AN_TRIG_N: R56.1, U12.R7 (IO_L24N_T3_A00_D16_14)
AN_TRIG_P: R56.2, U12.R6 (IO_L24P_T3_A01_D17_14)
CC_AB: R44.1, U12.L12 (IO_L6P_T0_FCS_B_14)
CH1_DC: U12.R12 (IO_L15P_T2_DQS_RDWR_B_14)
CH1_GND: U12.M12 (IO_L6N_T0_D08_VREF_14)
CH1_K: U12.P13 (IO_L11N_T1_SRCC_14)
CH2_DC: U12.N12 (IO_L13N_T2_MRCC_14)
CH2_GND: U12.N13 (IO_L11P_T1_SRCC_14)
CH2_K: U12.M15 (IO_L3N_T0_DQS_EMCCLK_14)
CLK_ADC_N: R51.2, U12.N14 (IO_L12P_T1_MRCC_14)
CLK_ADC_P: R51.1, U12.P14 (IO_L12N_T1_MRCC_14)
DAC_CLK_1: U12.M2 (IO_L2P_T0_34)
DAC_CLK_2: U12.M1 (IO_L2N_T0_34)
DAC_D0: U12.N1 (IO_L4P_T0_34)
DAC_D1: U12.N2 (IO_L3N_T0_DQS_34)
DAC_D2: U12.P1 (IO_L4N_T0_34)
DAC_D3: U12.P3 (IO_L5N_T0_34)
DAC_D4: U12.R1 (IO_L7N_T1_34)
DAC_D5: U12.R2 (IO_L7P_T1_34)
DAC_D6: U12.T2 (IO_L8N_T1_34)
DAC_D7: U12.R3 (IO_L8P_T1_34)
DAC_D8: U12.T3 (IO_L9N_T1_DQS_34)
DAC_D9: U12.P4 (IO_L5P_T0_34)
DAC_D10: U12.T4 (IO_L9P_T1_DQS_34)
DAC_D11: U12.P5 (IO_L10P_T1_34)
DAC_EN: R57.2, U12.T5 (IO_L23N_T3_A02_D18_14)
DAC_SLEEP: Q3.3 (D2)
DASCLK: U12.M4 (IO_L1N_T0_34)
DASDIN: U12.N3 (IO_L3P_T0_DQS_34)
DASYNC: U12.N4 (IO_L6N_T0_VREF_34)
DDR3_A0: U12.B15 (IO_L9P_T1_DQS_AD3P_15)
DDR3_A1: U12.B14 (IO_L8N_T1_AD10N_15)
DDR3_A2: U12.D10 (IO_0_15)
DDR3_A3: U12.D13 (IO_L12P_T1_MRCC_15)
DDR3_A4: U12.A9 (IO_L2N_T0_AD8N_15)
DDR3_A5: U12.D9 (IO_L6N_T0_VREF_15)
DDR3_A6: U12.A12 (IO_L5N_T0_AD9N_15)
DDR3_A7: U12.C16 (IO_L10P_T1_AD11P_15)
DDR3_A8: U12.B12 (IO_L5P_T0_AD9P_15)
DDR3_A9: U12.C14 (IO_L8P_T1_AD10P_15)
DDR3_A10: U12.C8 (IO_L1P_T0_AD0P_15)
DDR3_A11: U12.C13 (IO_L12N_T1_MRCC_15)
DDR3_A12: U12.C12 (IO_L11N_T1_SRCC_15)
DDR3_A13: U12.A15 (IO_L9N_T1_DQS_AD3N_15)
DDR3_A14: U12.A13 (IO_L7P_T1_AD2P_15)
DDR3_BA0: U12.C11 (IO_L11P_T1_SRCC_15)
DDR3_BA1: U12.B11 (IO_L4N_T0_15)
DDR3_BA2: U12.A14 (IO_L7N_T1_AD2N_15)
DDR3_CAS#: U12.B10 (IO_L4P_T0_15)
DDR3_CKE: U12.A8 (IO_L2P_T0_AD8P_15)
DDR3_CK_N: U12.A10 (IO_L3N_T0_DQS_AD1N_15)
DDR3_CK_P: U12.B9 (IO_L3P_T0_DQS_AD1P_15)
DDR3_DQ0: U12.H11 (IO_L19P_T3_A22_15)
DDR3_DQ1: U12.G12 (IO_L19N_T3_A21_VREF_15)
DDR3_DQ2: U12.H12 (IO_L20P_T3_A20_15)
DDR3_DQ3: U12.G16 (IO_L22N_T3_A16_15)
DDR3_DQ4: U12.J15 (IO_L23P_T3_FOE_B_15)
DDR3_DQ5: U12.J16 (IO_L23N_T3_FWE_B_15)
DDR3_DQ6: U12.H13 (IO_L20N_T3_A19_15)
DDR3_DQ7: U12.H16 (IO_L22P_T3_A17_15)
DDR3_DQ8: U12.E15 (IO_L18N_T2_A23_15)
DDR3_DQ9: U12.D16 (IO_L17N_T2_A25_15)
DDR3_DQ10: U12.D11 (IO_L14N_T2_SRCC_15)
DDR3_DQ11: U12.F13 (IO_L16N_T2_A27_15)
DDR3_DQ12: U12.F12 (IO_L16P_T2_A28_15)
DDR3_DQ13: U12.F15 (IO_L18P_T2_A24_15)
DDR3_DQ14: U12.E11 (IO_L14P_T2_SRCC_15)
DDR3_DQ15: U12.E16 (IO_L17P_T2_A26_15)
DDR3_DQS0_N: U12.F14 (IO_L21N_T3_DQS_A18_15)
DDR3_DQS0_P: U12.G14 (IO_L21P_T3_DQS_15)
DDR3_DQS1_N: U12.D15 (IO_L15N_T2_DQS_ADV_B_15)
DDR3_DQS1_P: U12.D14 (IO_L15P_T2_DQS_15)
DDR3_ODT: U12.C9 (IO_L1N_T0_AD0N_15)
DDR3_RAS#: U12.D8 (IO_L6P_T0_15)
DDR3_RESET#: U12.E12 (IO_L13P_T2_MRCC_15)
DDR3_WE#: U12.B16 (IO_L10N_T1_AD11N_15)
FLAGA: U12.D3 (IO_L11N_T1_SRCC_35)
FLAGB: U12.E5 (IO_L13N_T2_MRCC_35)
FLAGD: U12.E3 (IO_L11P_T1_SRCC_35)
GND: LED1.1 (K), LED2.1 (K), LED3.1 (K), Q3.1 (S1), Q3.4 (S2), SLP1.1 (K), SLP2.1 (K), SLP3.1 (K)
LED[1]: R58.2, U12.L4 (IO_L1P_T0_34)
LED[2]: R59.2, U12.L5 (IO_0_34)
LED[3]: R60.2, U12.M5 (IO_L6P_T0_34)
unnamed: LED1.2 (A), R58.1, SLP1.2 (A)
unnamed: LED2.2 (A), R59.1, SLP2.2 (A)
unnamed: LED3.2 (A), R60.1, SLP3.2 (A)
unnamed: Q3.2 (G1), R44.2
unnamed: Q3.5 (G2), R57.1
PKTEND: U12.C4 (IO_L12N_T1_MRCC_35)
RE7: Q3.6 (D1)
SLCS: U12.B1 (IO_L9N_T1_DQS_AD7N_35)
SLOE_SLRD: U12.C3 (IO_L7P_T1_AD6P_35)
SLWR: U12.C2 (IO_L7N_T1_AD6N_35)
SPI_MOSI: U12.J14 (IO_L1N_T0_D01_DIN_14)
clk_fx3: U12.C1 (IO_L9P_T1_DQS_AD7P_35)
dataA0_N: R50.1, U12.T15 (IO_L10N_T1_D15_14)
dataA0_P: R50.2, U12.T14 (IO_L10P_T1_D14_14)
dataA1_N: R53.1, U12.T13 (IO_L16N_T2_A15_D31_14)
dataA1_P: R53.2, U12.R13 (IO_L16P_T2_CSI_B_14)
dataA2_N: R52.1, U12.P11 (IO_L14N_T2_SRCC_14)
dataA2_P: R52.2, U12.P10 (IO_L14P_T2_SRCC_14)
dataA3_N: R54.1, U12.R11 (IO_L17N_T2_A13_D29_14)
dataA3_P: R54.2, U12.R10 (IO_L17P_T2_A14_D30_14)
dataA4_N: R55.1, U12.T10 (IO_L22N_T3_A04_D20_14)
dataA4_P: R55.2, U12.T9 (IO_L22P_T3_A05_D21_14)
dataB0_N: R45.1, U12.K16 (IO_L2N_T0_D03_14)
dataB0_P: R45.2, U12.K15 (IO_L2P_T0_D02_14)
dataB1_N: R47.2, U12.M16 (IO_L7P_T1_D09_14)
dataB1_P: R47.1, U12.N16 (IO_L7N_T1_D10_14)
dataB2_N: R46.1, U12.M14 (IO_L4N_T0_D05_14)
dataB2_P: R46.2, U12.L14 (IO_L4P_T0_D04_14)
dataB3_N: R48.1, U12.P16 (IO_L8N_T1_D12_14)
dataB3_P: R48.2, U12.P15 (IO_L8P_T1_D11_14)
dataB4_N: R49.1, U12.R16 (IO_L9N_T1_DQS_D13_14)
dataB4_P: R49.2, U12.R15 (IO_L9P_T1_DQS_14)
dataD[0]: U12.L3 (IO_L23P_T3_35)
dataD[1]: U12.K1 (IO_L22P_T3_35)
dataD[2]: U12.K2 (IO_L24N_T3_35)
dataD[3]: U12.J1 (IO_L22N_T3_35)
dataD[4]: U12.K3 (IO_L24P_T3_35)
dataD[5]: U12.R5 (IO_L23P_T3_A03_D19_14)
dataD[6]: U12.P6 (IO_25_14)
dataD[7]: U12.N6 (IO_L19N_T3_A09_D25_VREF_14)
dataD[8]: U12.L2 (IO_L23N_T3_35)
dataD[9]: U12.M6 (IO_L19P_T3_A10_D26_14)
dataD[10]: U12.J3 (IO_L21P_T3_DQS_35)
dataD[11]: U12.K5 (IO_25_35)
dir_5_0: U12.P9 (IO_L18N_T2_A11_D27_14)
dir_11_6: U12.N9 (IO_L18P_T2_A12_D28_14)
dpot_cs: U12.N11 (IO_L13P_T2_MRCC_14)
dpot_sck: U12.P8 (IO_L20P_T3_A08_D24_14)
dpot_si: U12.J13 (IO_L1P_T0_D00_MOSI_14)
faddr[0]: U12.F3 (IO_L14N_T2_SRCC_35)
faddr[1]: U12.D1 (IO_L10N_T1_AD15N_35)
fdata[0]: U12.A7 (IO_L1N_T0_AD4N_35)
fdata[1]: U12.D6 (IO_L6P_T0_35)
fdata[2]: U12.J5 (IO_L19P_T3_35)
fdata[3]: U12.B7 (IO_L1P_T0_AD4P_35)
fdata[4]: U12.C7 (IO_L5P_T0_AD13P_35)
fdata[5]: U12.B5 (IO_L2N_T0_AD12N_35)
fdata[6]: U12.B6 (IO_L2P_T0_AD12P_35)
fdata[7]: U12.B4 (IO_L4P_T0_35)
fdata[8]: U12.D5 (IO_L6N_T0_VREF_35)
fdata[9]: U12.D4 (IO_L12P_T1_MRCC_35)
fdata[10]: U12.A5 (IO_L3P_T0_DQS_AD5P_35)
fdata[11]: U12.A3 (IO_L4N_T0_35)
fdata[12]: U12.A4 (IO_L3N_T0_DQS_AD5N_35)
fdata[13]: U12.B2 (IO_L8P_T1_AD14P_35)
fdata[14]: U12.A2 (IO_L8N_T1_AD14N_35)
fdata[15]: U12.C6 (IO_L5N_T0_AD13N_35)
fdata[16]: U12.E2 (IO_L10P_T1_AD15P_35)
fdata[17]: U12.E6 (IO_0_35)
fdata[18]: U12.E1 (IO_L15N_T2_DQS_35)
fdata[19]: U12.F2 (IO_L15P_T2_DQS_35)
fdata[20]: U12.F4 (IO_L14P_T2_SRCC_35)
fdata[21]: U12.G2 (IO_L17P_T2_35)
fdata[22]: U12.G1 (IO_L17N_T2_35)
fdata[23]: U12.F5 (IO_L13P_T2_MRCC_35)
fdata[24]: U12.H5 (IO_L18P_T2_35)
fdata[25]: U12.H2 (IO_L20P_T3_35)
fdata[26]: U12.J4 (IO_L19N_T3_VREF_35)
fdata[27]: U12.H4 (IO_L18N_T2_35)
fdata[28]: U12.G4 (IO_L16N_T2_35)
fdata[29]: U12.H1 (IO_L20N_T3_35)
fdata[30]: U12.G5 (IO_L16P_T2_35)
fdata[31]: U12.H3 (IO_L21N_T3_DQS_35)

Notes on the sheet:
PUDC_B = High I/Os 3-state during configuration
INVERTED POLARITY B1
INVERTED POLARITY CLK
