OWON-LILLIPUT/scopefun-hardware/(notices)

Notices in the files:
KiCadSource/file56948067.sch:
Copyright Dejan Priversek 2017
